jason-curtis/keyball/keyball61-choc/renders/left_bottom.png

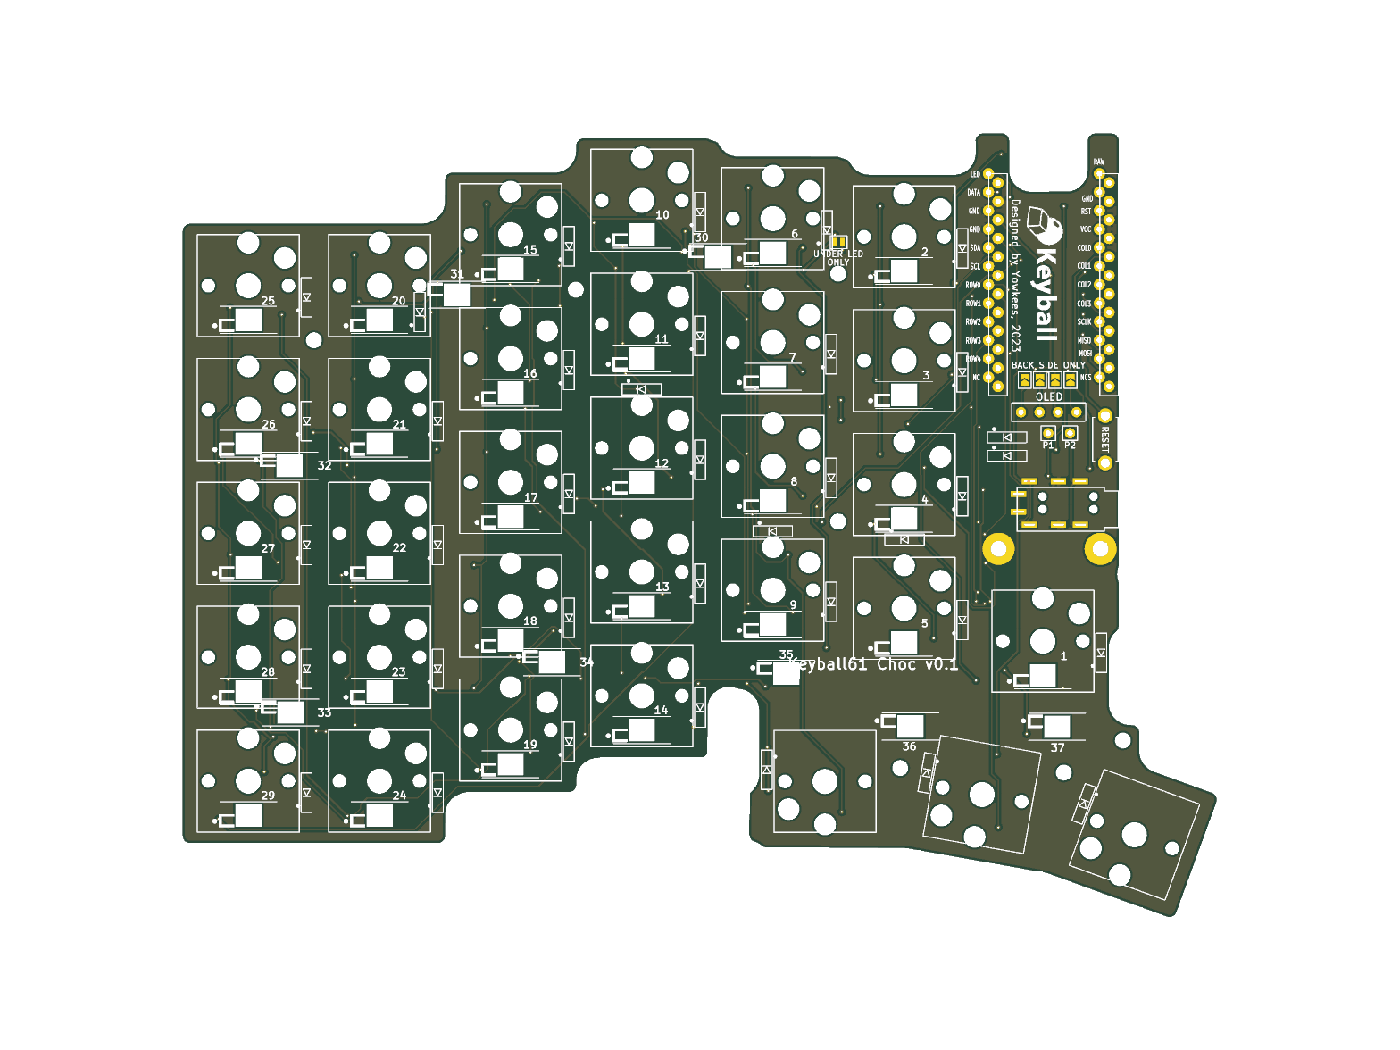
keyball61-choc/renders/left_bottom.png
