jason-curtis/keyball/keyball61-choc/renders/left_top.png

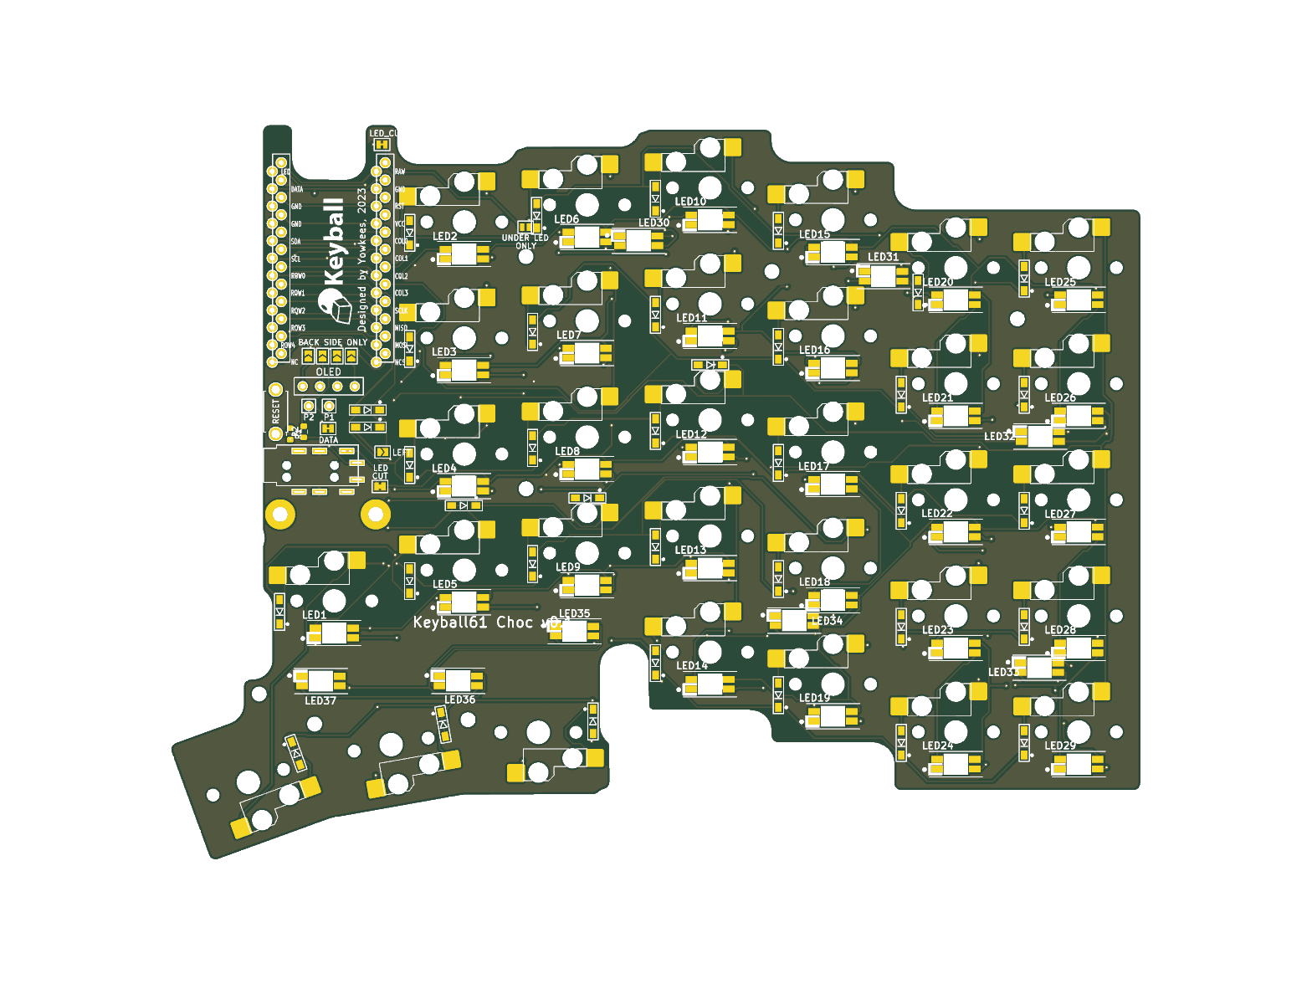
keyball61-choc/renders/left_top.png
