jason-curtis/keyball/keyball61-choc/renders/right_bottom.png

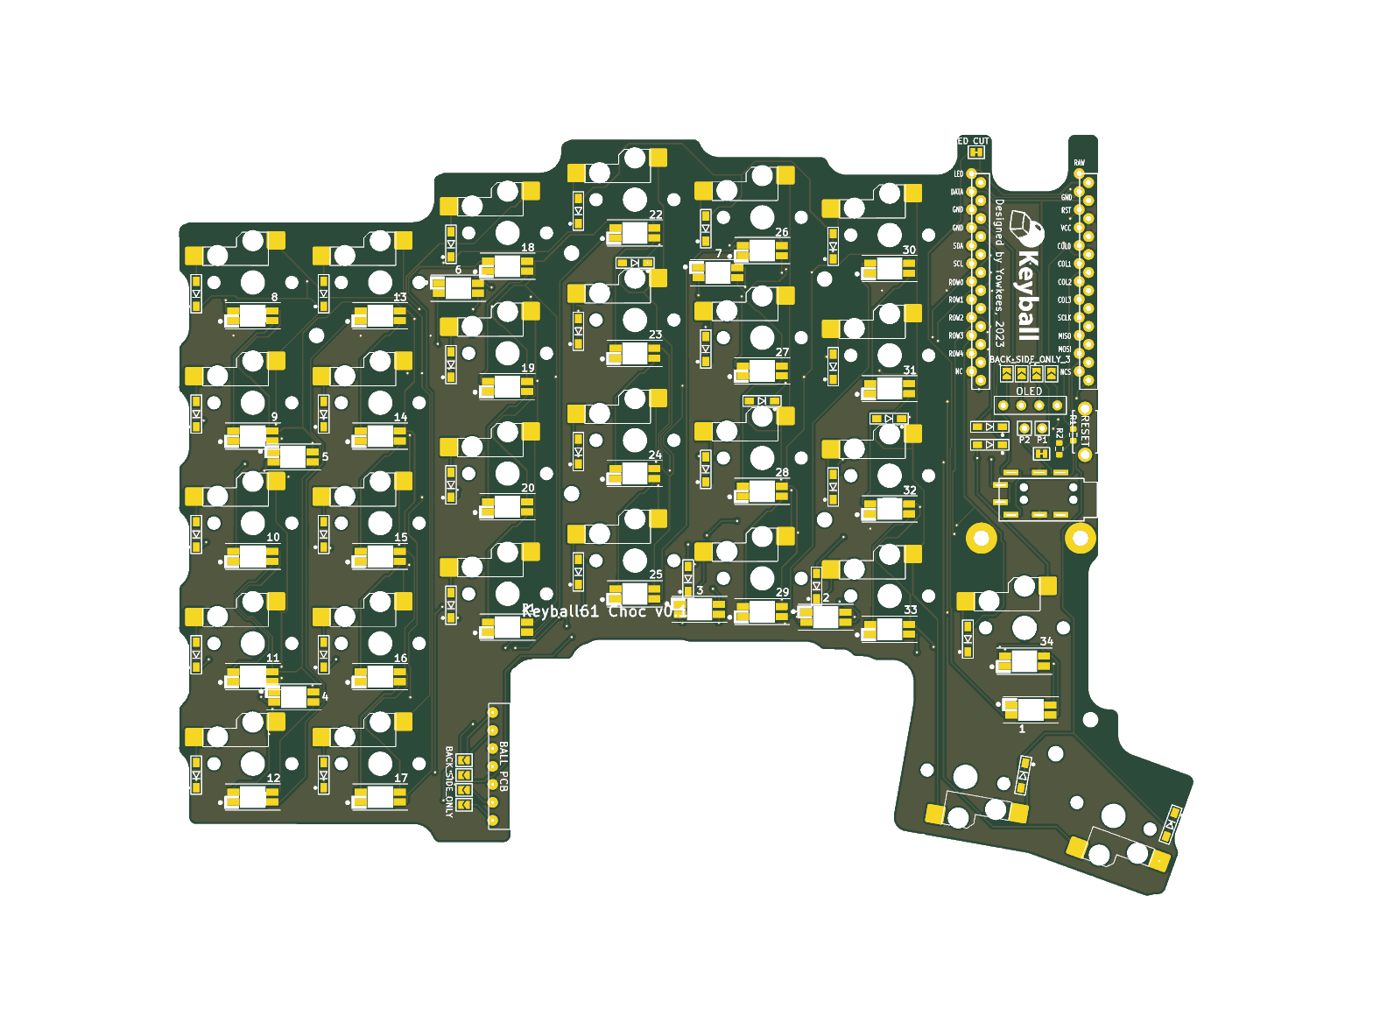
keyball61-choc/renders/right_bottom.png
