jason-curtis/keyball/keyball61-choc/renders/right_top.png

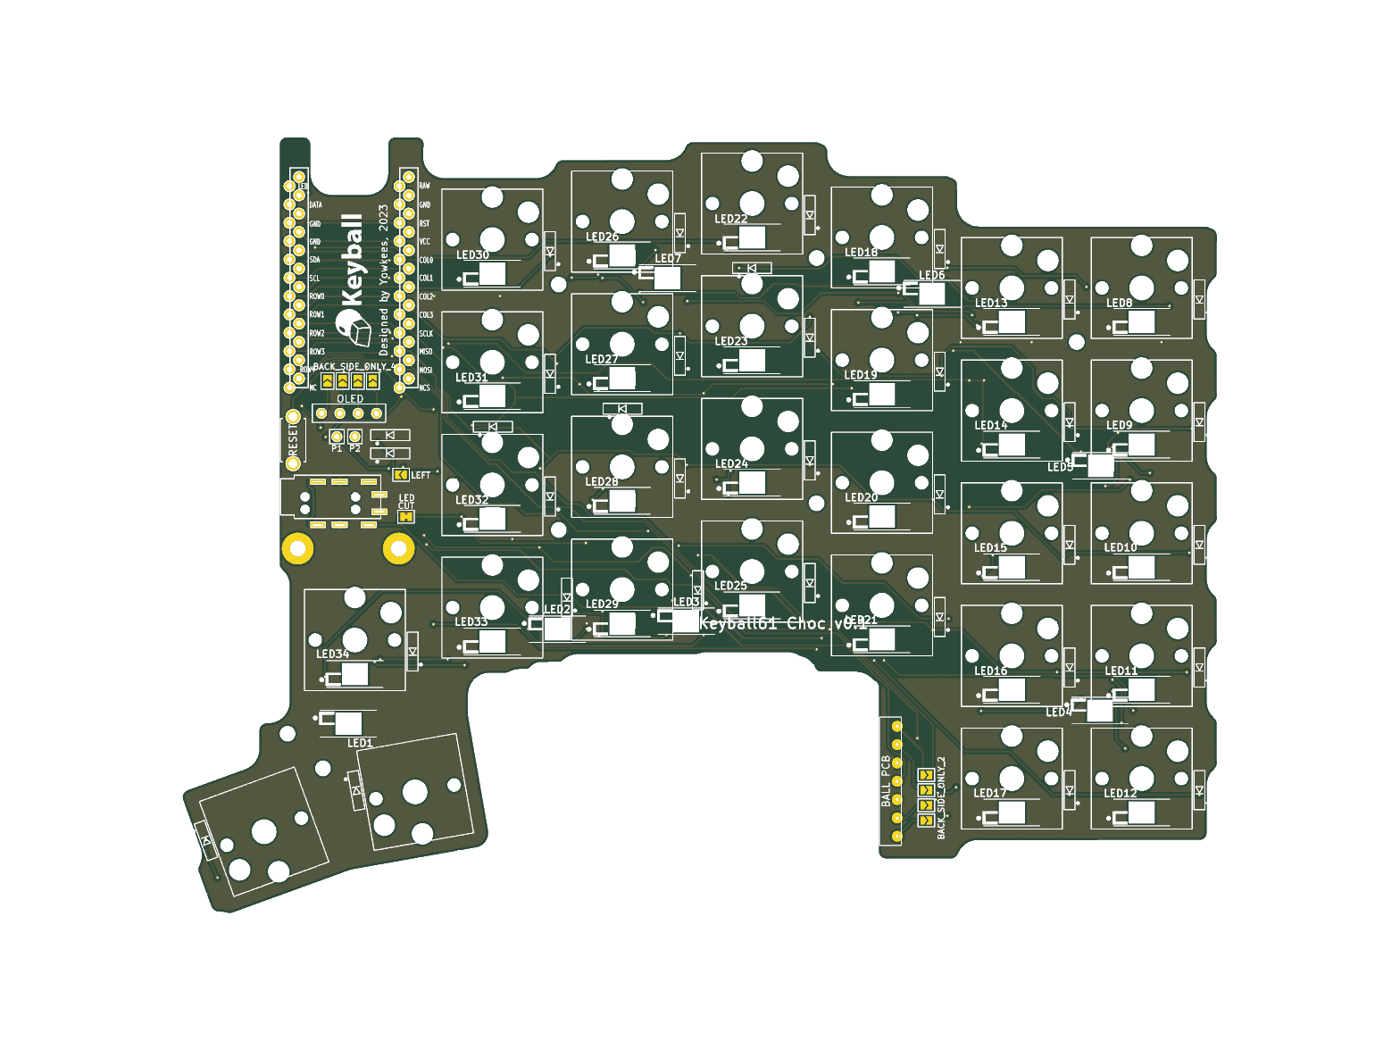
keyball61-choc/renders/right_top.png
