jason-curtis/keyball/keyball61-choc/fab/left/keyball61_choc_left_bom_jlc.csv

Comment | Designator | Footprint | LCSC Part # | Qty | Assembly
1N4148W SOD-123 | D1,D10,D11,D12,D13,D14,D15,D16,D17,D18,D19,D2,D20,D21,D22,D23,D24,D25,D26,D27,D28,D29,D3,D30,D31,D32,D33,D34,D35,D36,D37,D4,D5,D6,D7,D8,D9 | D3_SMD_v2_BOTH | C81598 | 37 | SMT
4.7k 0603 1% | R1,R2 | R_0603_1608Metric | C23162 | 2 | SMT
Kailh Choc v1 hotswap socket CPG135001S30 | SW1,SW10,SW11,SW12,SW13,SW14,SW15,SW16,SW17,SW18,SW19,SW2,SW20,SW21,SW22,SW23,SW24,SW25,SW26,SW27,SW28,SW29,SW3,SW30,SW31,SW32,SW4,SW5,SW6,SW7,SW8,SW9 | Choc_V1_Hotswap | C5333465 | 32 | SMT
PJ-320A TRRS jack (check pinout vs MJ-4PP-9 footprint) | J13 | TRRS_JACK_MJ4PP9 | C2884926 | 1 | THT-optional
SK6812MINI-E reverse-mount RGB LED | LED30,LED31,LED32,LED33,LED34,LED35,LED36,LED37 | YS-SK6812MINI-Keyball-BL | C5149201 | 8 | SMT
SK6812MINI-E reverse-mount RGB LED | LED1,LED10,LED11,LED12,LED13,LED14,LED15,LED16,LED17,LED18,LED19,LED2,LED20,LED21,LED22,LED23,LED24,LED25,LED26,LED27,LED28,LED29,LED3,LED4,LED5,LED6,LED7,LED8,LED9 | YS-SK6812MINI-Keyball-TL | C5149201 | 29 | SMT
Tactile switch 2-pin 6x3.5 (SKHLLCA010) | SW33 | ResetSW | C139766 | 1 | THT-optional
