jason-curtis/keyball/keyball61-choc/case/keyball61_choc_left_bottom_2mm.dxf

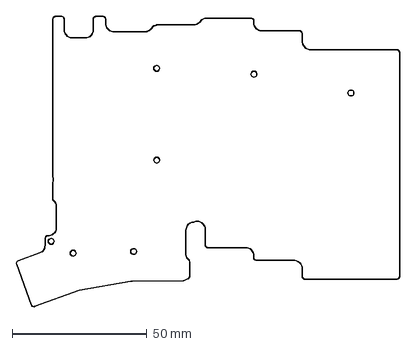
[picture p5: CAD file, 2026-10-12]
keyball61-choc/case/keyball61_choc_left_bottom_2mm.dxf
141.9 x 107.5 mm
