jason-curtis/keyball/keyball61-choc/case/keyball61_choc_right_bottom_2mm.dxf

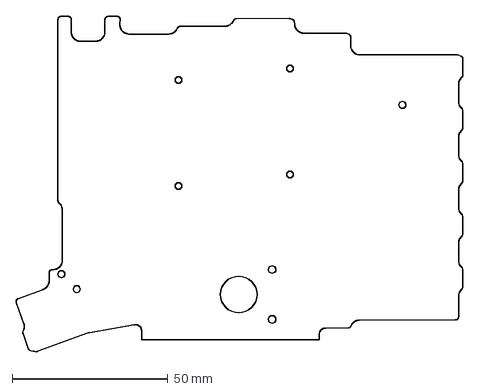
[picture p6: CAD file, 2026-10-12]
keyball61-choc/case/keyball61_choc_right_bottom_2mm.dxf
143.3 x 107.5 mm
