jason-curtis/keyball/keyball61-choc/pcb/right/keyball61_choc_right.kicad_pcb

## KiCad design keyball61-choc/pcb/right/keyball61_choc_right.kicad_pcb (2026-10-12)

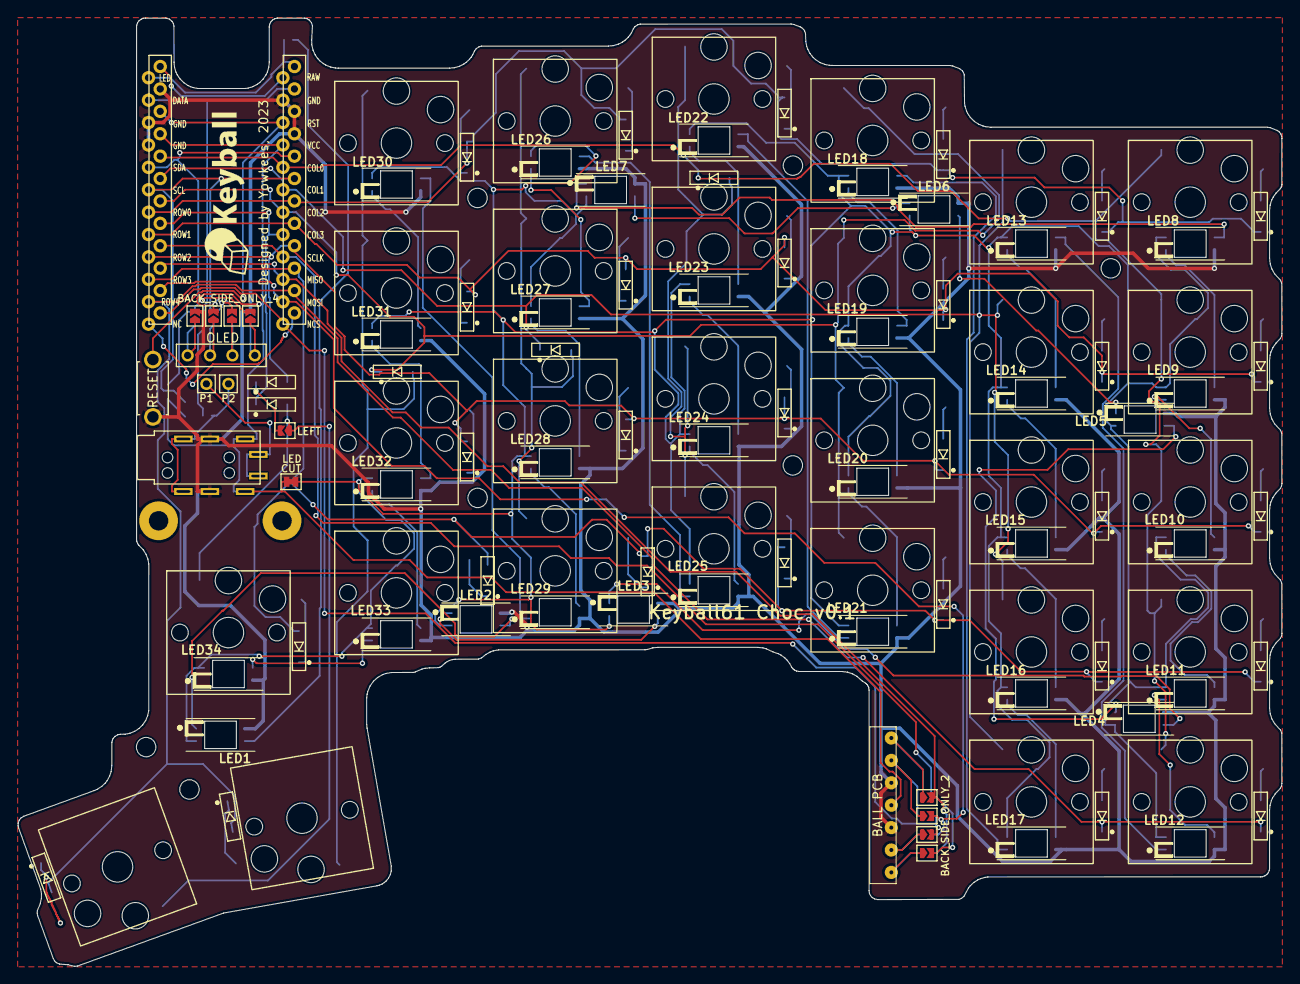
[picture p7: board keyball61_choc_right.kicad_pcb from above]

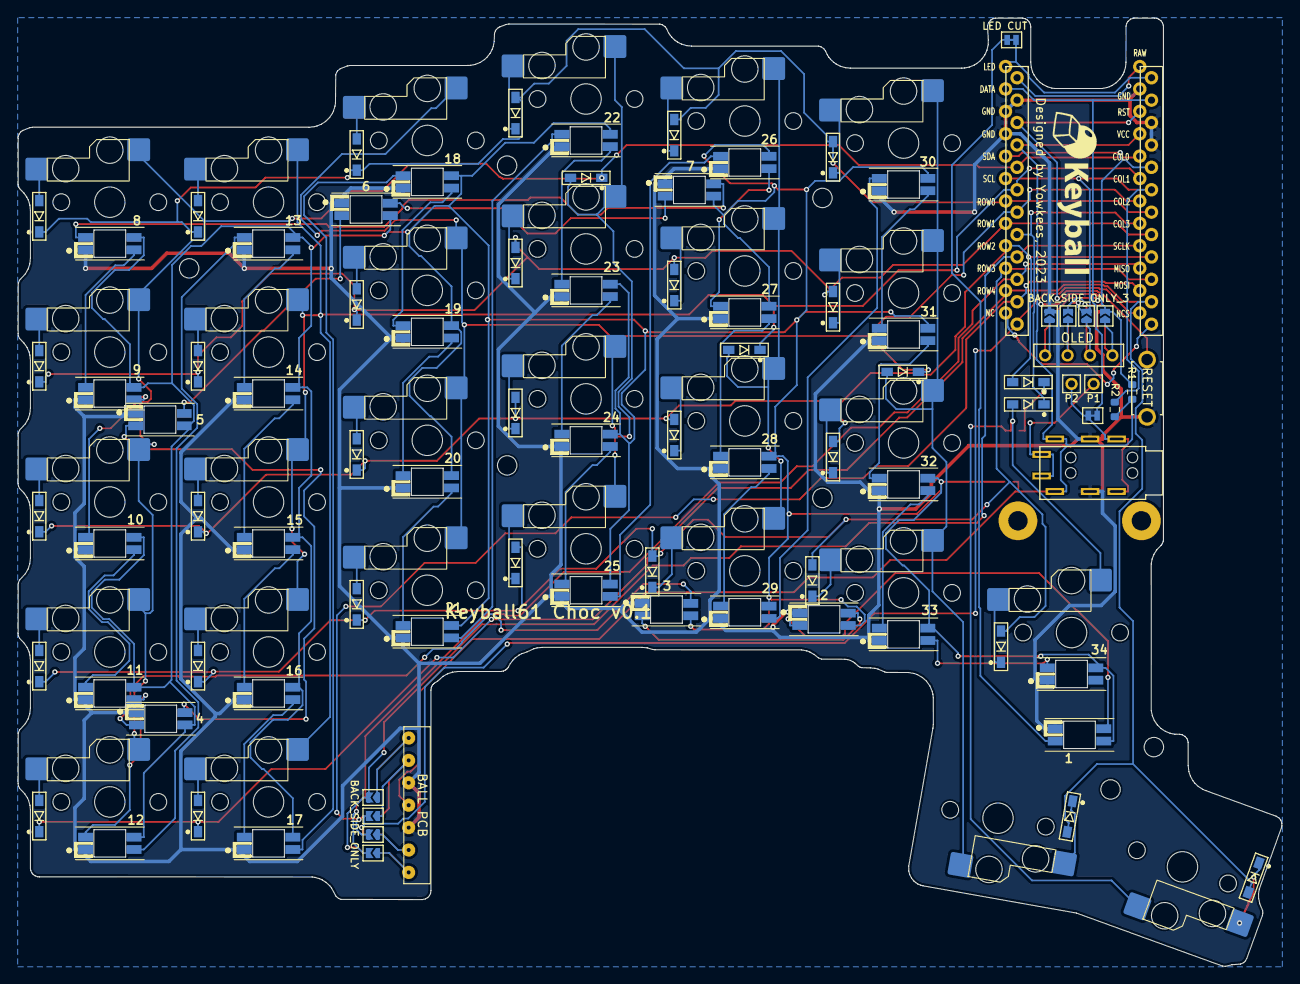
[picture p8: board keyball61_choc_right.kicad_pcb from below]

Board: 2 copper layers, 143.3 x 107.5 mm, 137 parts (13 on the bottom side), 99 nets.

Parts:
BACK_SIDE_ONLY: Device_Jumper_NO_Small; Jumper_NEW
BACK_SIDE_ONLY_2, BACK_SIDE_ONLY_3, BACK_SIDE_ONLY_4: Device_Jumper_NO_Small; Jumper_NEW
D1, D2, D3, D4, D5, D6, D7, D8, D9, D10, D11, D12, D13, D14, D15, D16, D17, D18, D19, D20, D21, D22, D23, D24, D25, D26, D27, D28, D29, D30, D31, D32, D33, D34: D; D3_SMD_v2_BOTH
GXXX: LOGO; keyball_logo700
GXXX_2: LOGO; keyball_logo700
J1: OLED
J2: BALL_PCB; Mac8_L_7pin_contact_NEW2023
J3, J4: Conn_01x01-Connector_Generic; MountingHole_2.2mm_M2_Pad
J13: TRS_JACK; TRRS_JACK_MJ4PP9
JP1, JP2, JP3, JP4, JP7, JP8, JP10, JP11, JP12, JP13, JP15, JP16: Device_Jumper_NO_Small; Jumper_NEW
JP18: Device_Jumper; JP025
JP20: LED CUT; JP025
LED: CUT; JP06
LED1, LED2, LED3, LED4, LED5, LED6, LED7: YS-SK6812MINI-E; YS-SK6812MINI-Keyball-BL
LED8, LED9, LED10, LED11, LED12, LED13, LED14, LED15, LED16, LED17, LED18, LED19, LED20, LED21, LED22, LED23, LED24, LED25, LED26, LED27, LED28, LED29, LED30, LED31, LED32, LED33, LED34: YS-SK6812MINI-E; YS-SK6812MINI-Keyball-TL
LEFT: Device_Jumper_NO_Small; Jumper_NEW
MH5, MH6, MH7, MH8, MH9, MH11, MH12: M2; MountingHole_2.2mm_M2
P1, P2: I2C; 1pin_conn
R1, R2: PULL_UP; R_0603_1608Metric
SW1, SW2, SW3, SW4, SW5, SW6, SW7, SW8, SW9, SW10, SW11, SW12, SW13, SW14, SW15, SW16, SW17, SW18, SW19, SW20, SW21, SW22, SW23, SW24, SW25, SW26, SW27, SW28, SW29: Choc_V1; Choc_V1_Hotswap
SW30: RESET_SW; ResetSW
U1: ProMicro-kbd; ProMicro_v2_for61

Connections:
COL0: D31.1, SW1.1, SW7.1, SW13.1, SW19.1, SW26.1, U1.20
COL1: D32.1, SW2.1, SW8.1, SW14.1, SW20.1, SW27.1, U1.19
COL2: D33.1, SW3.1, SW9.1, SW15.1, SW21.1, U1.18
COL3: D34.1, U1.17
DATA: JP18.2, U1.2
GND: BACK_SIDE_ONLY_3.2, J2.3, J2.5, J13.C, JP2.2, LED1.3, LED2.3, LED3.3, LED4.3, LED5.3, LED6.3, LED7.3, LED8.3, LED9.3, LED10.3, LED11.3, LED12.3, LED13.3, LED14.3, LED15.3, LED16.3, LED17.3, LED18.3, LED19.3, LED20.3, LED21.3, LED22.3, LED23.3, LED24.3, LED25.3, LED26.3, LED27.3, LED28.3, LED29.3, LED30.3, LED31.3, LED32.3, LED33.3, LED34.3, SW30.2, U1.3, U1.4, U1.23
LED: JP20.1, U1.1
MISO: JP1.2, JP16.2, U1.15
MOSI: BACK_SIDE_ONLY.2, JP3.2, U1.14
NCS: BACK_SIDE_ONLY_2.2, JP12.2, U1.13
unnamed: D1.2, SW1.2
unnamed: D2.2, SW2.2
unnamed: D3.2, SW3.2
unnamed: D4.1, SW4.2
unnamed: D5.1, SW5.2
unnamed: D6.1, SW6.2
unnamed: D7.2, SW7.2
unnamed: D8.2, SW8.2
unnamed: D9.2, SW9.2
unnamed: D10.1, SW10.2
unnamed: D11.1, SW11.2
unnamed: D12.1, SW12.2
unnamed: D13.2, SW13.2
unnamed: D14.2, SW14.2
unnamed: D15.2, SW15.2
unnamed: D16.1, SW16.2
unnamed: D17.1, SW17.2
unnamed: D18.1, SW18.2
unnamed: D19.2, SW19.2
unnamed: D20.2, SW20.2
unnamed: D21.2, SW21.2
unnamed: D22.1, SW22.2
unnamed: D23.1, SW23.2
unnamed: D24.1, SW24.2
unnamed: D25.1, SW25.2
unnamed: D26.2, SW26.2
unnamed: D27.2, SW27.2
unnamed: D28.1, SW28.2
unnamed: D29.1, SW29.2
unnamed: D30.1, LEFT.2
unnamed: D31.2, SW4.1, SW10.1, SW16.1, SW22.1
unnamed: D32.2, SW5.1, SW11.1, SW17.1, SW23.1
unnamed: D33.2, SW6.1, SW12.1, SW18.1, SW24.1, SW28.1
unnamed: D34.2, LEFT.1, SW25.1, SW29.1
unnamed: J1.1, JP2.1, JP11.1
unnamed: J1.2, JP4.1, JP13.1
unnamed: BACK_SIDE_ONLY_4.1, J1.3, JP15.1
unnamed: BACK_SIDE_ONLY_3.1, J1.4, JP8.1
unnamed: J2.1, JP1.1, JP10.1
unnamed: J2.2, JP3.1, JP12.1
unnamed: BACK_SIDE_ONLY.1, BACK_SIDE_ONLY_2.1, J2.6
unnamed: J2.7, JP7.1, JP16.1
unnamed: J13.A, P1.1
unnamed: J13.B, JP18.1, P2.1
unnamed: LED.1, LED1.1, LED2.1, LED3.1, LED4.1, LED5.1, LED6.1, LED7.1, LED8.1, LED9.1, LED10.1, LED11.1, LED12.1, LED13.1, LED14.1, LED15.1, LED16.1, LED17.1, LED18.1, LED19.1, LED20.1, LED21.1, LED22.1, LED23.1, LED24.1, LED25.1, LED26.1, LED27.1, LED28.1, LED29.1, LED30.1, LED31.1, LED32.1, LED33.1, LED34.1
unnamed: JP20.2, LED1.4
unnamed: LED1.2, LED2.4
unnamed: LED2.2, LED3.4
unnamed: LED3.2, LED4.4
unnamed: LED4.2, LED5.4
unnamed: LED5.2, LED6.4
unnamed: LED6.2, LED7.4
unnamed: LED7.2, LED8.4
unnamed: LED8.2, LED9.4
unnamed: LED10.2, LED11.4
unnamed: LED9.2, LED10.4
unnamed: LED11.2, LED12.4
unnamed: LED12.2, LED13.4
unnamed: LED13.2, LED14.4
unnamed: LED14.2, LED15.4
unnamed: LED15.2, LED16.4
unnamed: LED16.2, LED17.4
unnamed: LED17.2, LED18.4
unnamed: LED18.2, LED19.4
unnamed: LED19.2, LED20.4
unnamed: LED20.2, LED21.4
unnamed: LED21.2, LED22.4
unnamed: LED22.2, LED23.4
unnamed: LED23.2, LED24.4
unnamed: LED24.2, LED25.4
unnamed: LED25.2, LED26.4
unnamed: LED26.2, LED27.4
unnamed: LED27.2, LED28.4
unnamed: LED28.2, LED29.4
unnamed: LED29.2, LED30.4
unnamed: LED30.2, LED31.4
unnamed: LED31.2, LED32.4
unnamed: LED32.2, LED33.4
unnamed: LED33.2, LED34.4
RESET: SW30.1, U1.22
ROW0: D1.1, D2.1, D3.1, D4.2, D5.2, D6.2, U1.7
ROW1: D7.1, D8.1, D9.1, D10.2, D11.2, D12.2, U1.8
ROW2: D13.1, D14.1, D15.1, D16.2, D17.2, D18.2, D30.2, U1.9
ROW3: D19.1, D20.1, D21.1, D22.2, D23.2, D24.2, D25.2, U1.10
ROW4: D26.1, D27.1, D28.2, D29.2, U1.11
SCL: BACK_SIDE_ONLY_4.2, JP13.2, R2.2, U1.6
SCLK: JP7.2, JP10.2, U1.16
SDA: JP8.2, JP11.2, R1.2, U1.5
VCC: J2.4, J13.D, JP4.2, JP15.2, LED.2, R1.1, R2.1, U1.21
