jason-curtis/keyball/(commit log)

2026-10-11 Add Keyball61 Choc build kit research and priced BOM
    Claude-Session: https://claude.ai/code/session_012Lz4SD3XgX9T3cBqnotnnt
2026-10-11 Add Keyball61 Choc conversion tooling, footprints and build kit
    Scripts convert Yowkees' Keyball61 KiCad boards to Kailh Choc v1 at
    18x17 mm spacing (keeping matrix, ball notch and thumbs), autoroute with
    Freerouting, and generate fab outputs and acrylic bottom plates.
    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
2026-10-11 WIP: left half after two-pass routing (DRC not yet clean; superseded by next run)
    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
    [keyball61_choc_left.kicad_pcb]
2026-10-12 route.py: two passes with timeout, rotated custom pads, 0.2/0.15 mm rules
    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
2026-10-12 WIP: routed left/right boards from previous run (DRC: L 10 err/7 open, R 9 err/11 open)
    Superseded by the routing run in progress.
    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
    [keyball61_choc_left.kicad_pcb, keyball61_choc_right.kicad_pcb]
2026-10-12 convert: diodes beside socket pad 2, drop M2 holes that can't clear housings; route: drop Keyball per-pad clearance override
    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
2026-10-12 WIP: routed boards from previous run (DRC: L 4 err/3 open, R 10 err/8 open)
    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
    [keyball61_choc_left.kicad_pcb, keyball61_choc_right.kicad_pcb]
2026-10-12 Ignore routing scratch boards and DRC json
    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
2026-10-12 WIP: boards from previous routing run (DRC: L 14 err/2 open, R 28 err/6 open)
    Superseded by the iterative routing run in progress.
    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
    [keyball61_choc_left.kicad_pcb, keyball61_choc_right.kicad_pcb]
2026-10-12 Iteratively routed boards (0 DRC violations; L 2 / R 7 open) + fixup.py grid router with rip-up
    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
    [keyball61_choc_left.kicad_pcb, keyball61_choc_right.kicad_pcb]
2026-10-12 Treat LED cut-outs as filled keep-outs; chain fixup router after Freerouting
    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
2026-10-12 Keyball61 Choc v0.1: DRC-clean routed PCBs, JLC fab files, bottom plates, renders
    Both halves: 0 DRC errors, 0 unconnected (KiCad 9). Gerbers + drill,
    JLC BOM/CPL (single-sided assembly), 2 mm acrylic bottom plates with the
    original trackball-case holes, and 3D renders. Docs updated.
    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
    [keyball61_choc_left.kicad_pcb, keyball61_choc_left_bom_jlc.csv, keyball61_choc_left_bottom_2mm.dxf, keyball61_choc_right.kicad_pcb, keyball61_choc_right_bom_jlc.csv, keyball61_choc_right_bottom_2mm.dxf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]
